webprofusion/open-pedal/enclosure/assets/tablet-screen.png

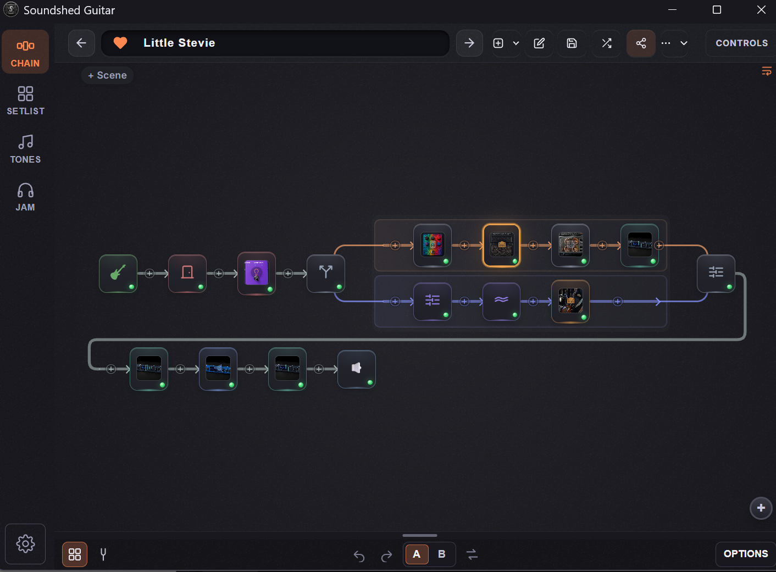
enclosure/assets/tablet-screen.png
