webprofusion/open-pedal/enclosure/renders/holder-phone.png

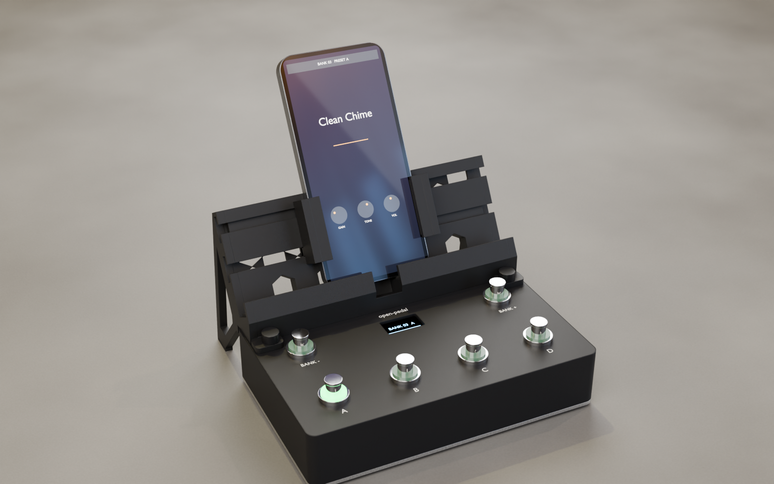
enclosure/renders/holder-phone.png
