webprofusion/open-pedal/enclosure/renders/holder-rear.png

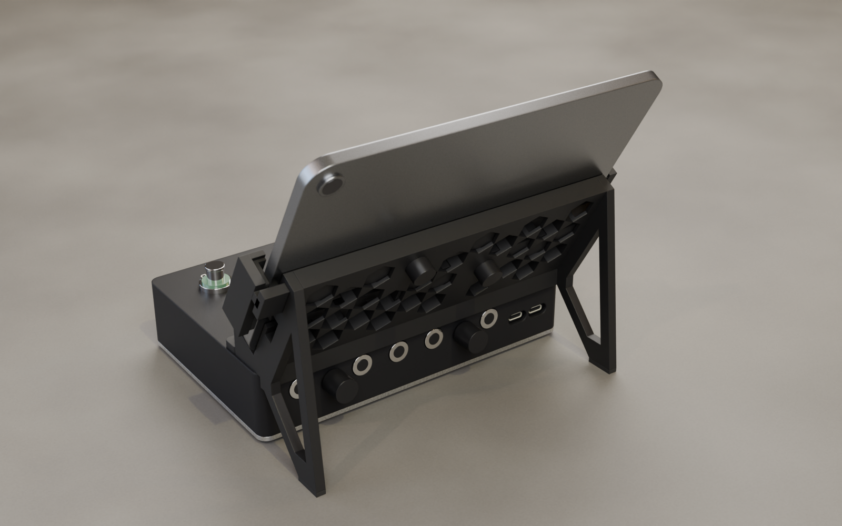
enclosure/renders/holder-rear.png
