webprofusion/open-pedal/enclosure/renders/inside.png

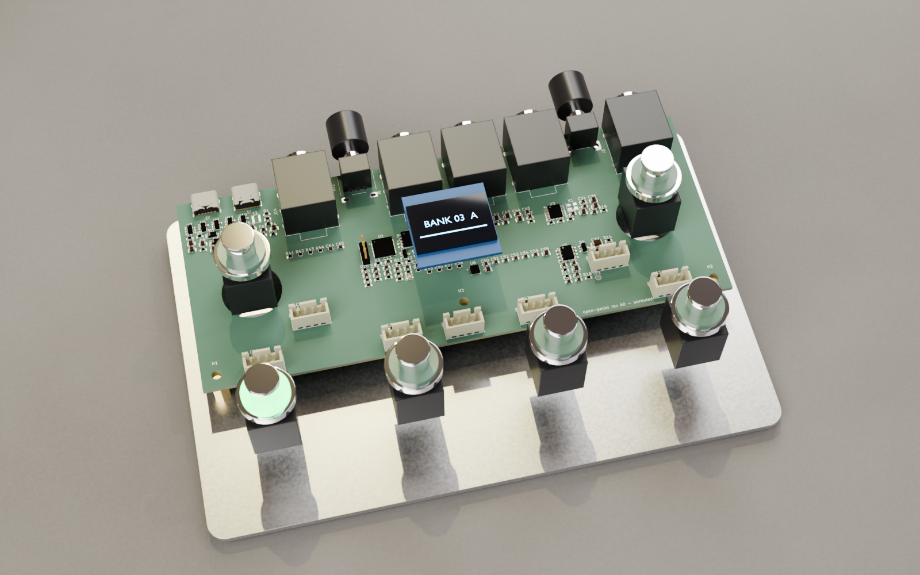
enclosure/renders/inside.png
