webprofusion/open-pedal/enclosure/renders/rear.png

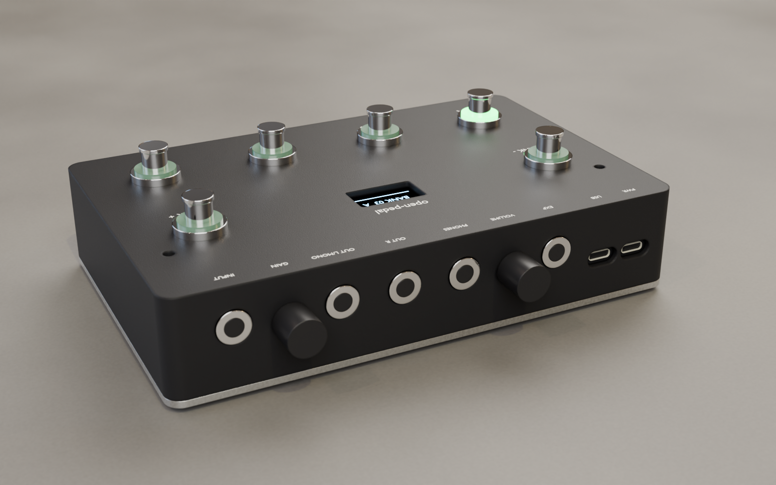
enclosure/renders/rear.png
