webprofusion/open-pedal/hardware/kicad/exports/open-pedal-board.png

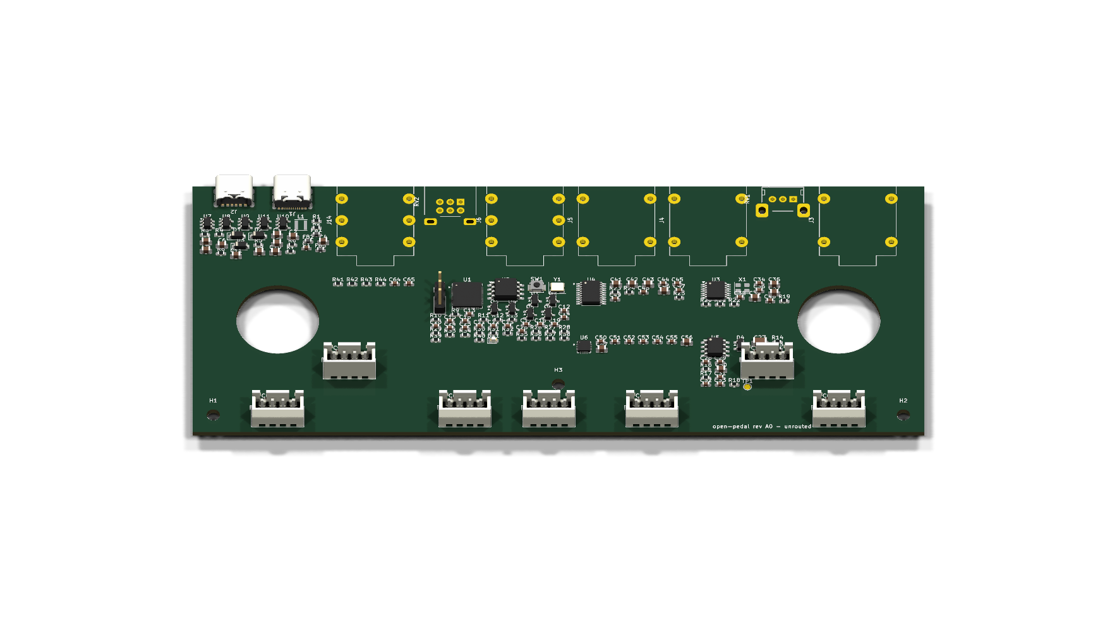
hardware/kicad/exports/open-pedal-board.png
