webprofusion/open-pedal/hardware/kicad/exports/open-pedal-schematic.pdf

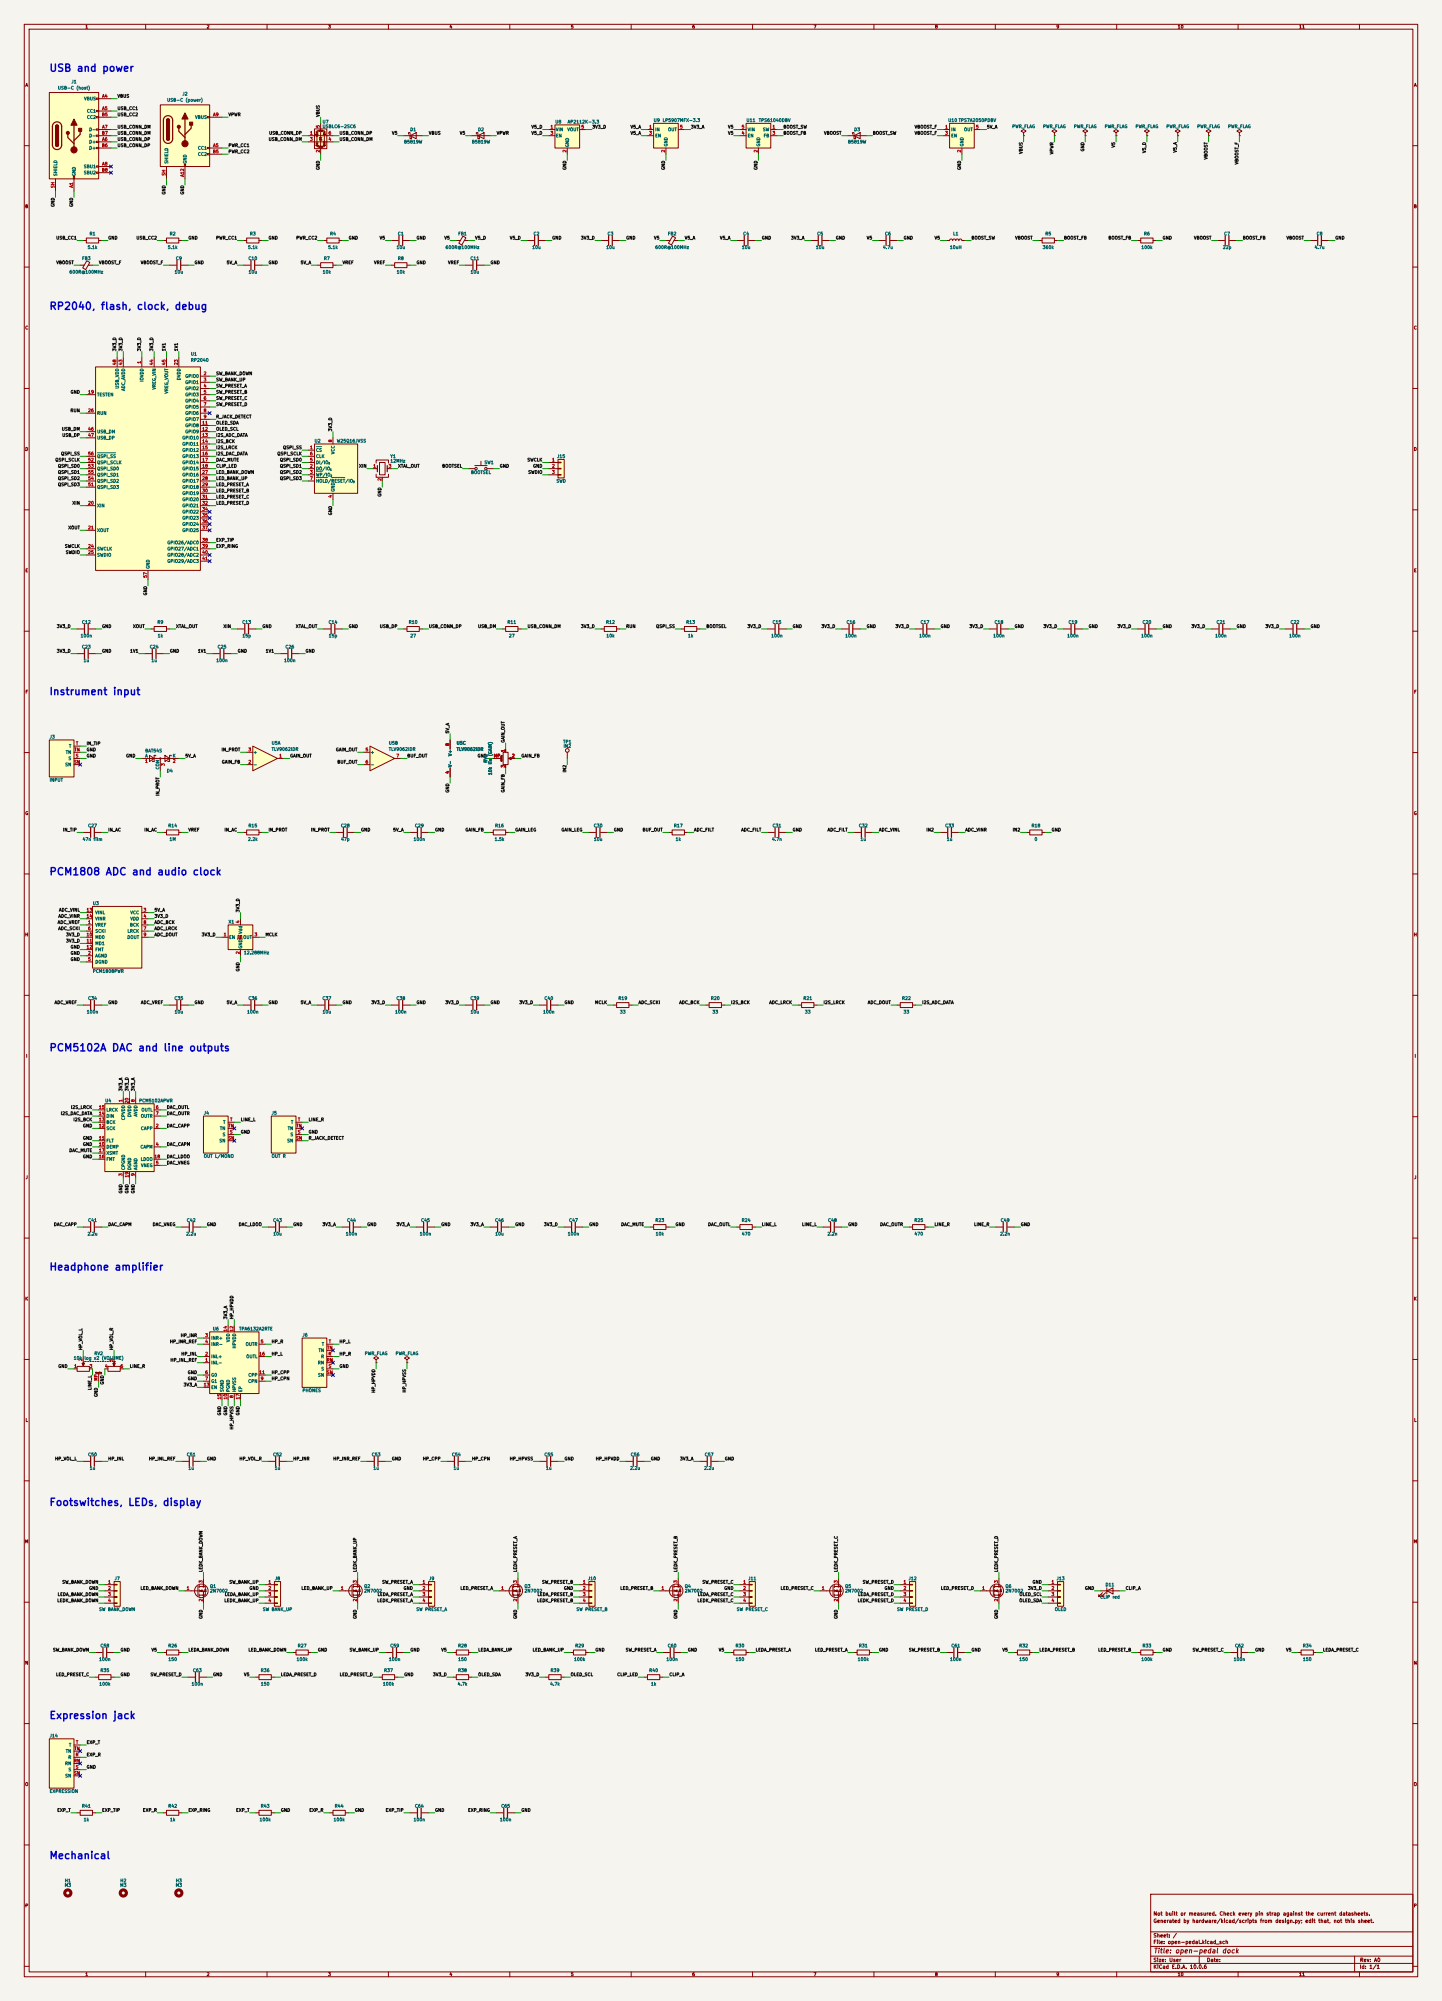
[picture p9: page 1]

4 DI/IO0 5 CLK 6 HOLD/RESET/IO3 7 VCC U2 8W25Q16JVSS

PCM1808 ADC and audio clock

PCM5102A DAC and line outputs

SCK 12 BCK 13 DIN 14 LRCK 15

8 CPN 9 PGND 10 CPP 11 HPVDD 12

GND Footswitches, LEDs, display

Not built or measured. Check every pin strap against the current datasheets.
Generated by hardware/kicad/scripts from design.py; edit that, not this sheet.

Sheet: /
File: open-pedal.kicad_sch
Title: open-pedal dock

Size: User | Rev: A0
KiCad E.D.A. 10.0.6 | Id: 1/1
