webprofusion/open-pedal/hardware/kicad/open-pedal.kicad_pcb

## KiCad design hardware/kicad/open-pedal.kicad_pcb (2026-11-10)

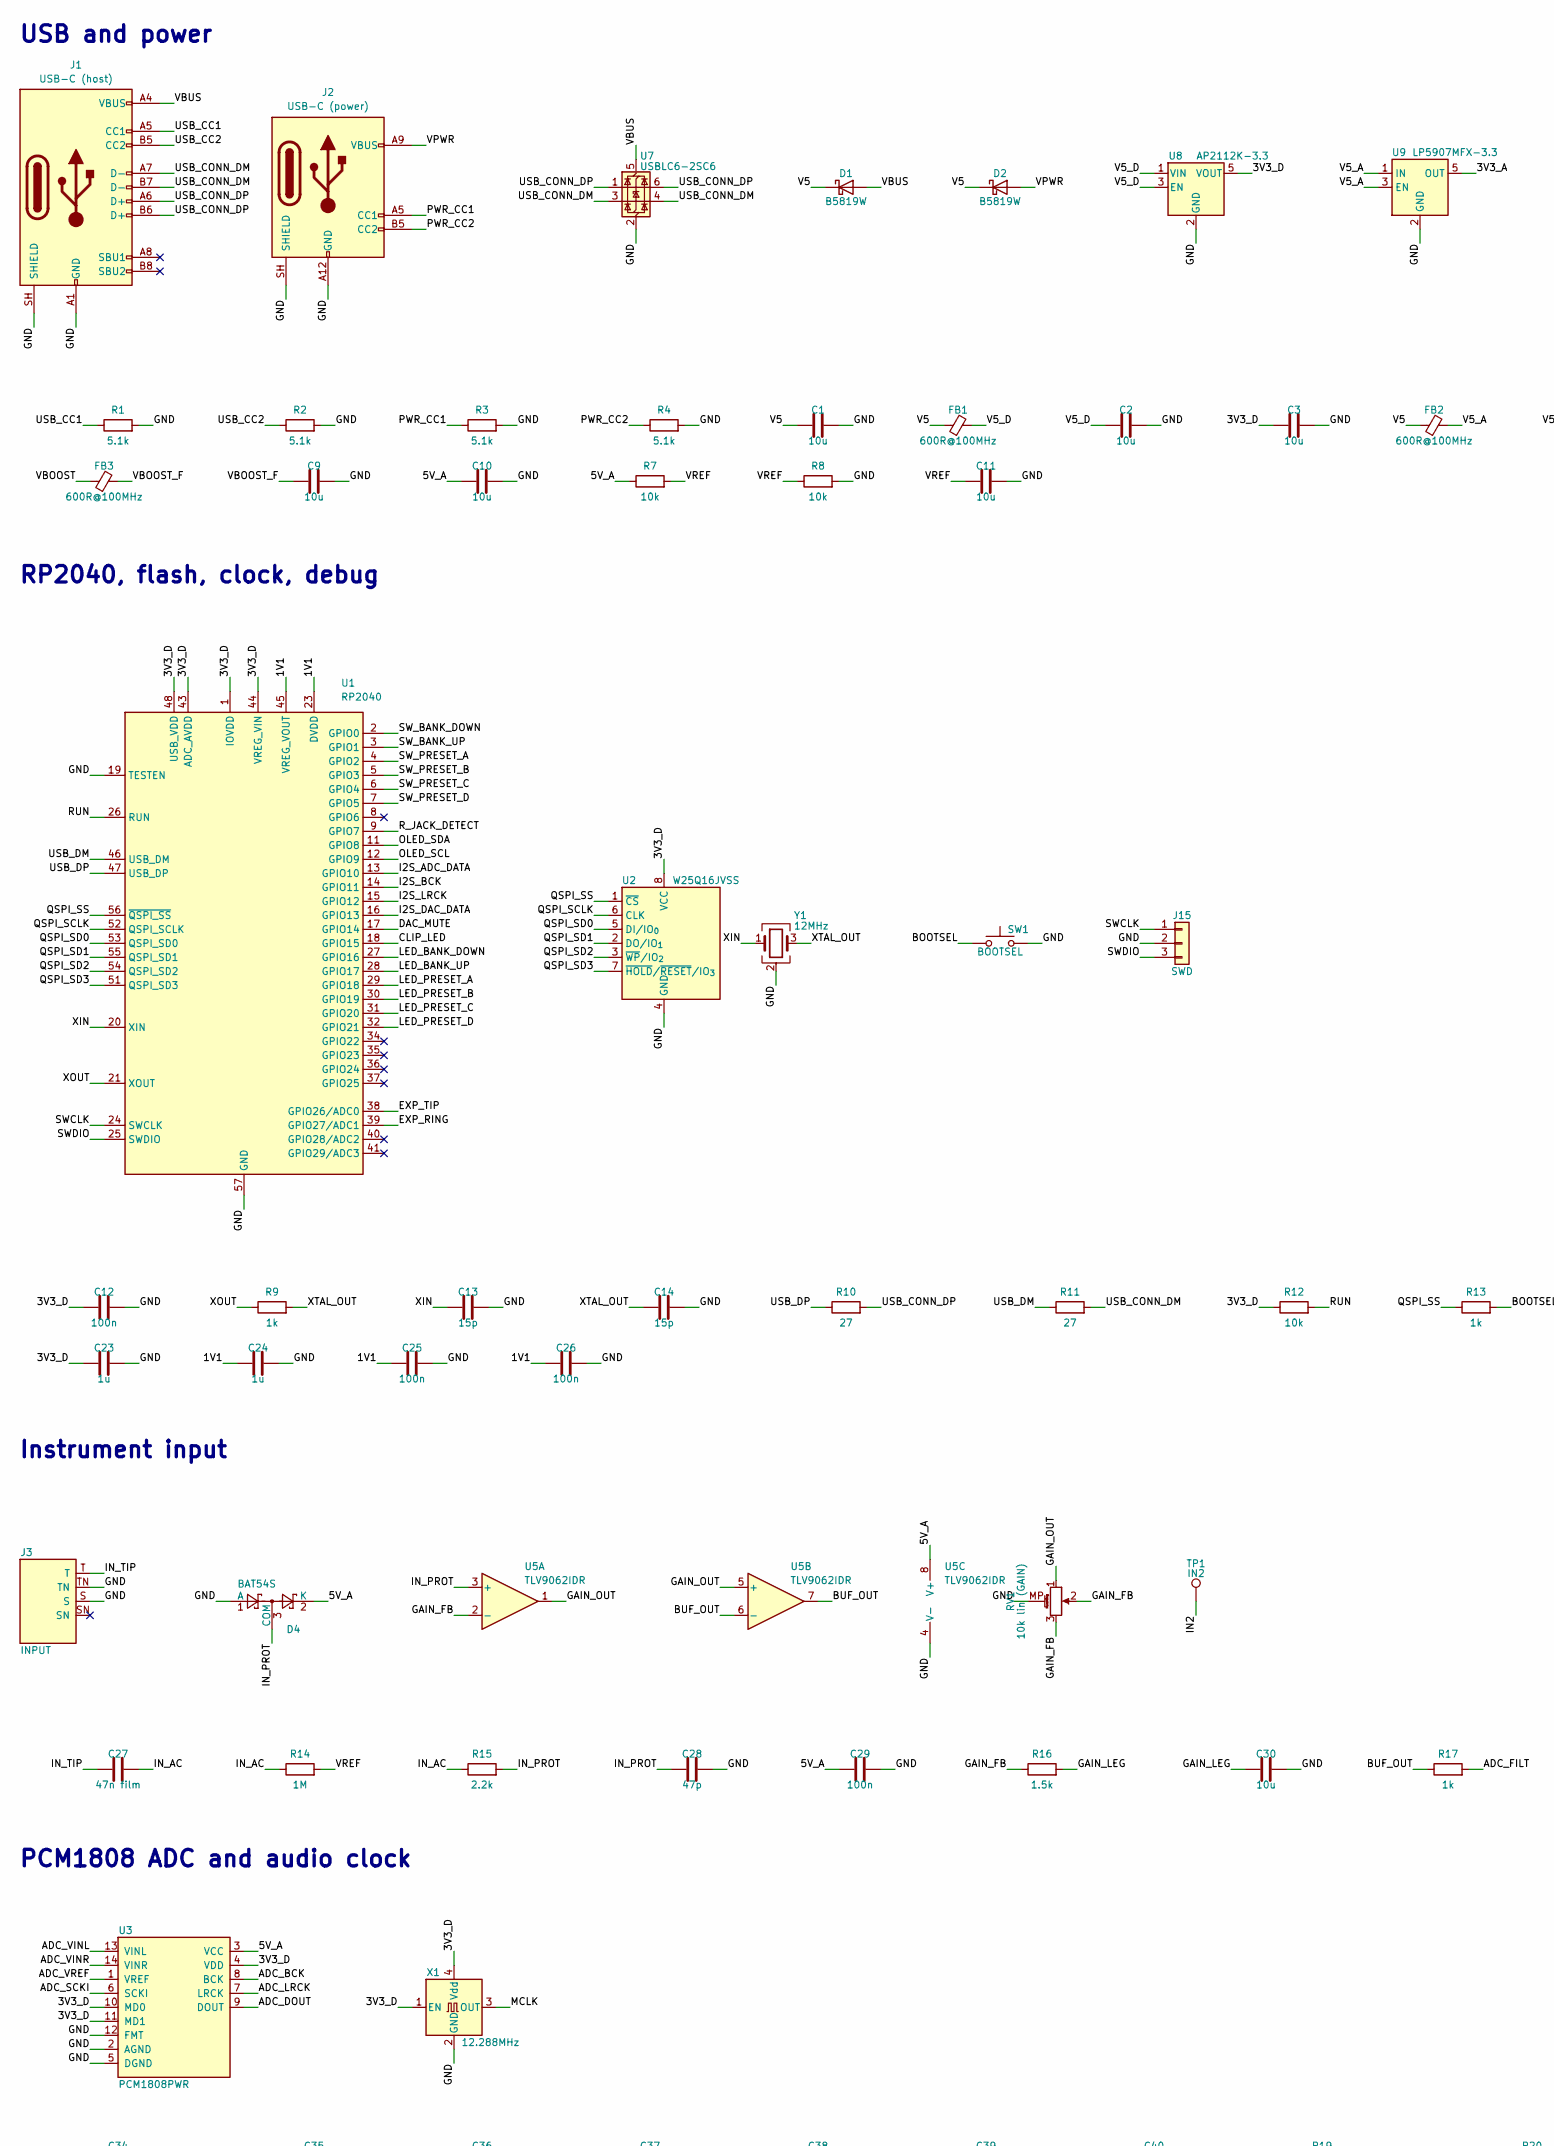
[picture p10: schematic open-pedal.kicad_sch, open-pedal dock, part in row 1, column 1]

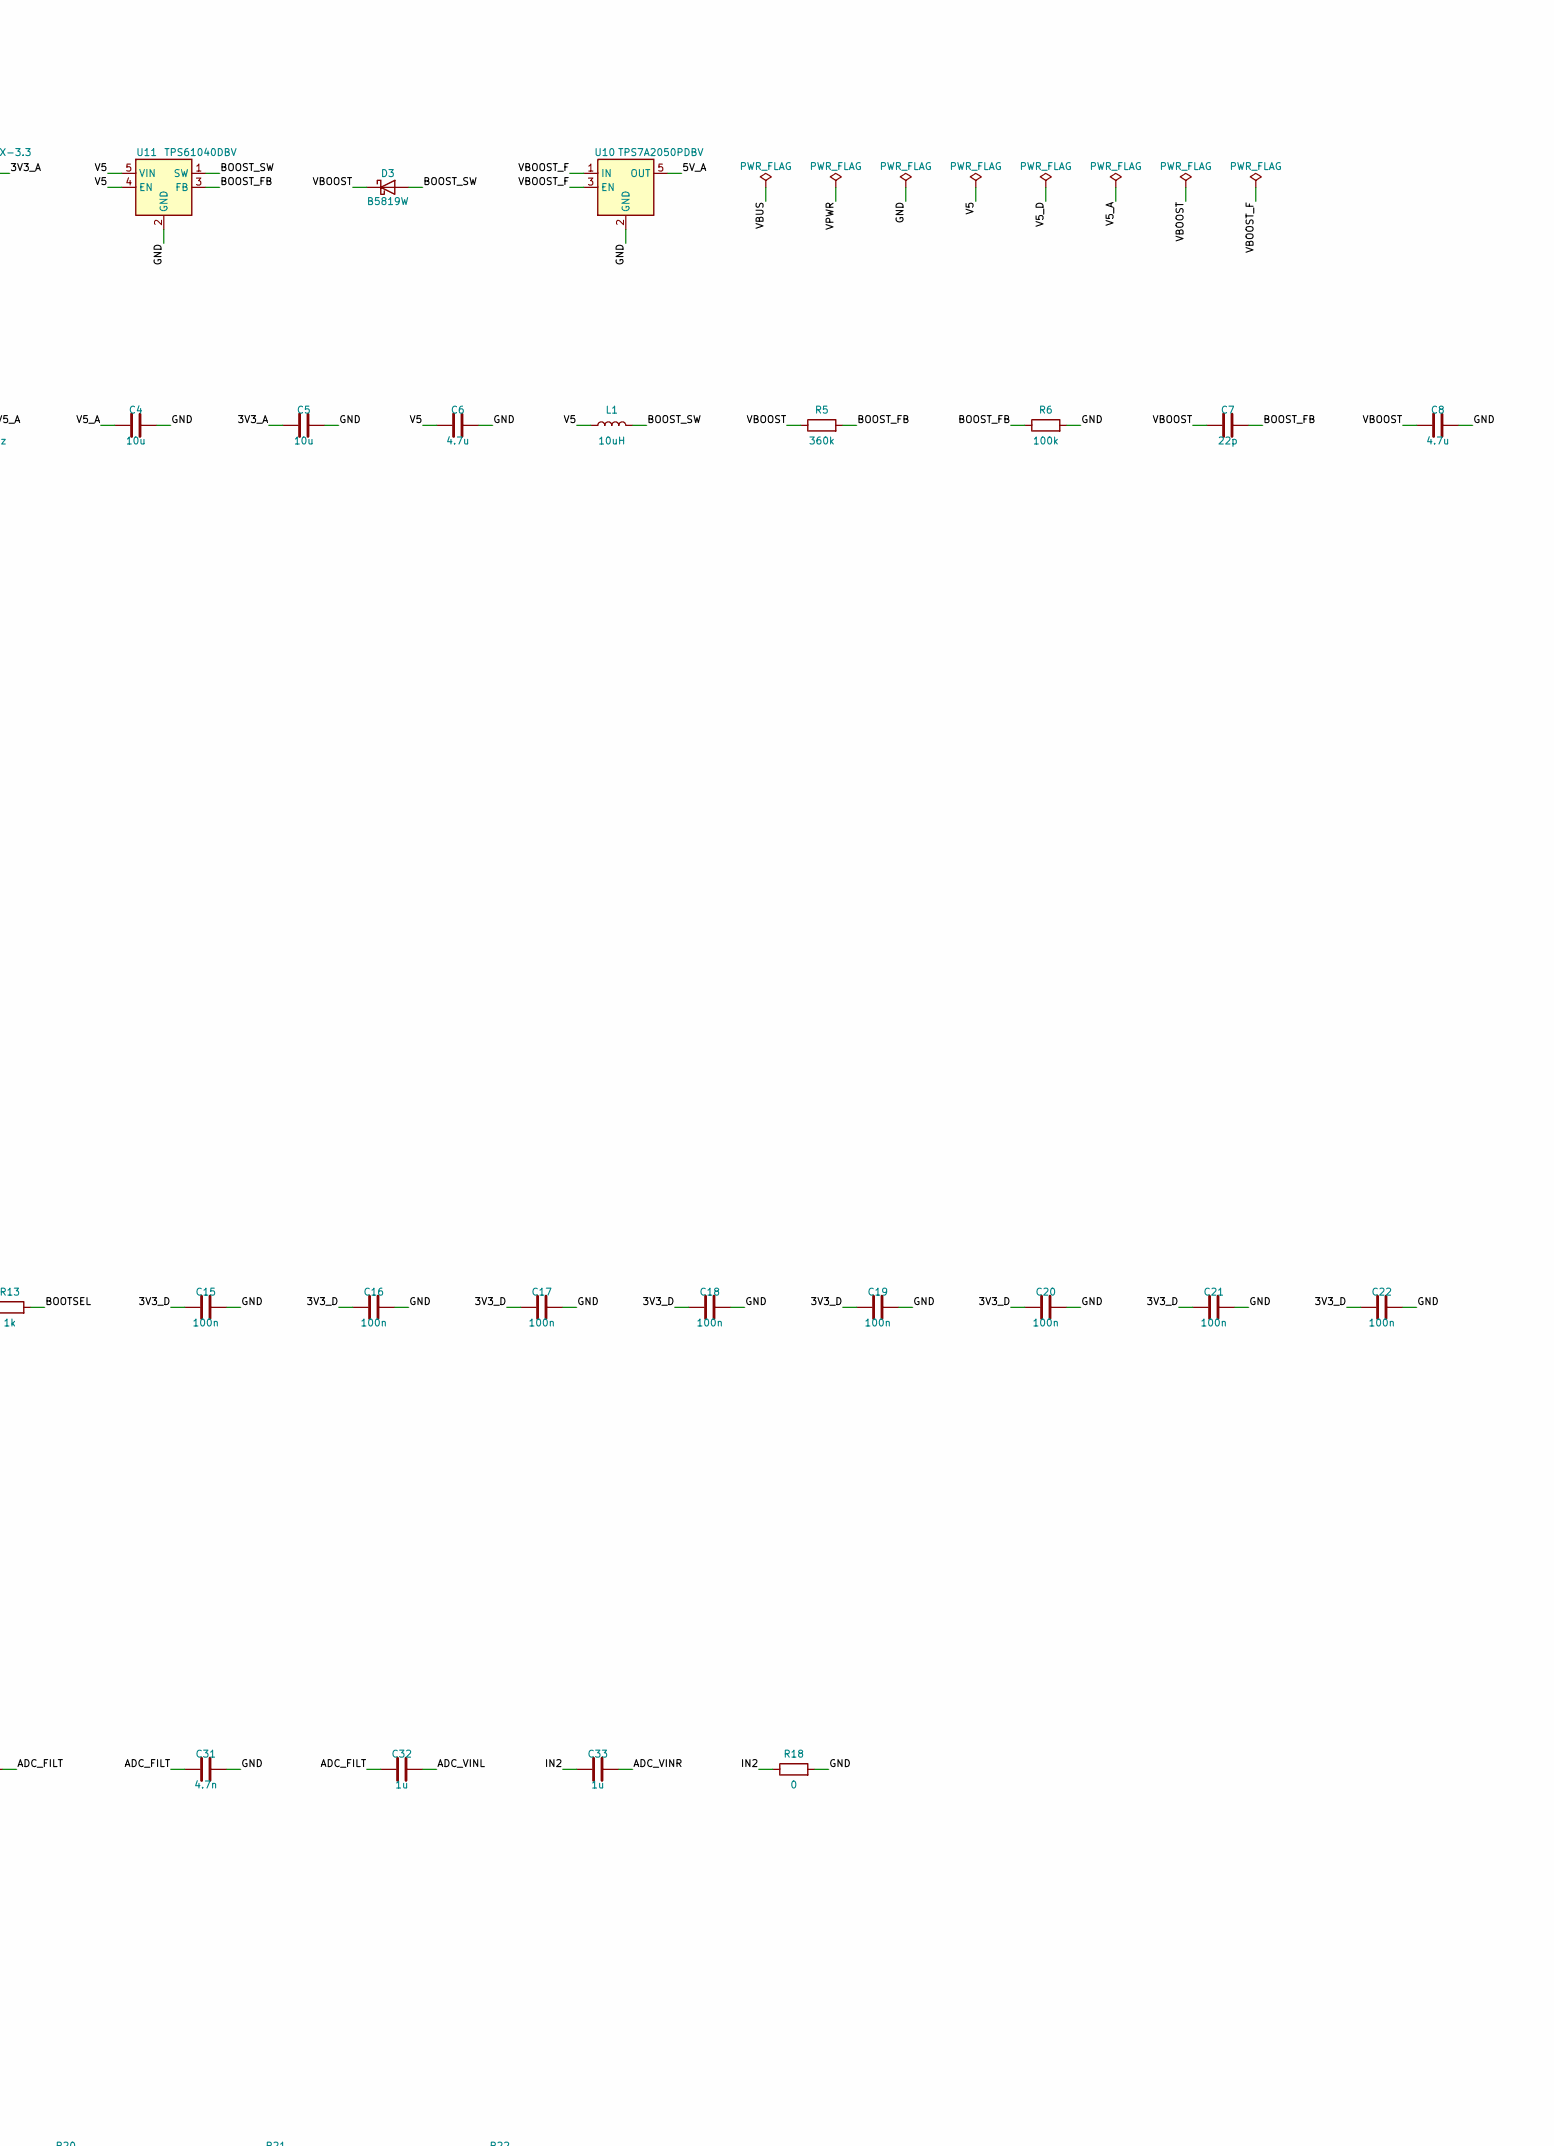
[picture p11: schematic open-pedal.kicad_sch, open-pedal dock, part in row 1, column 2]

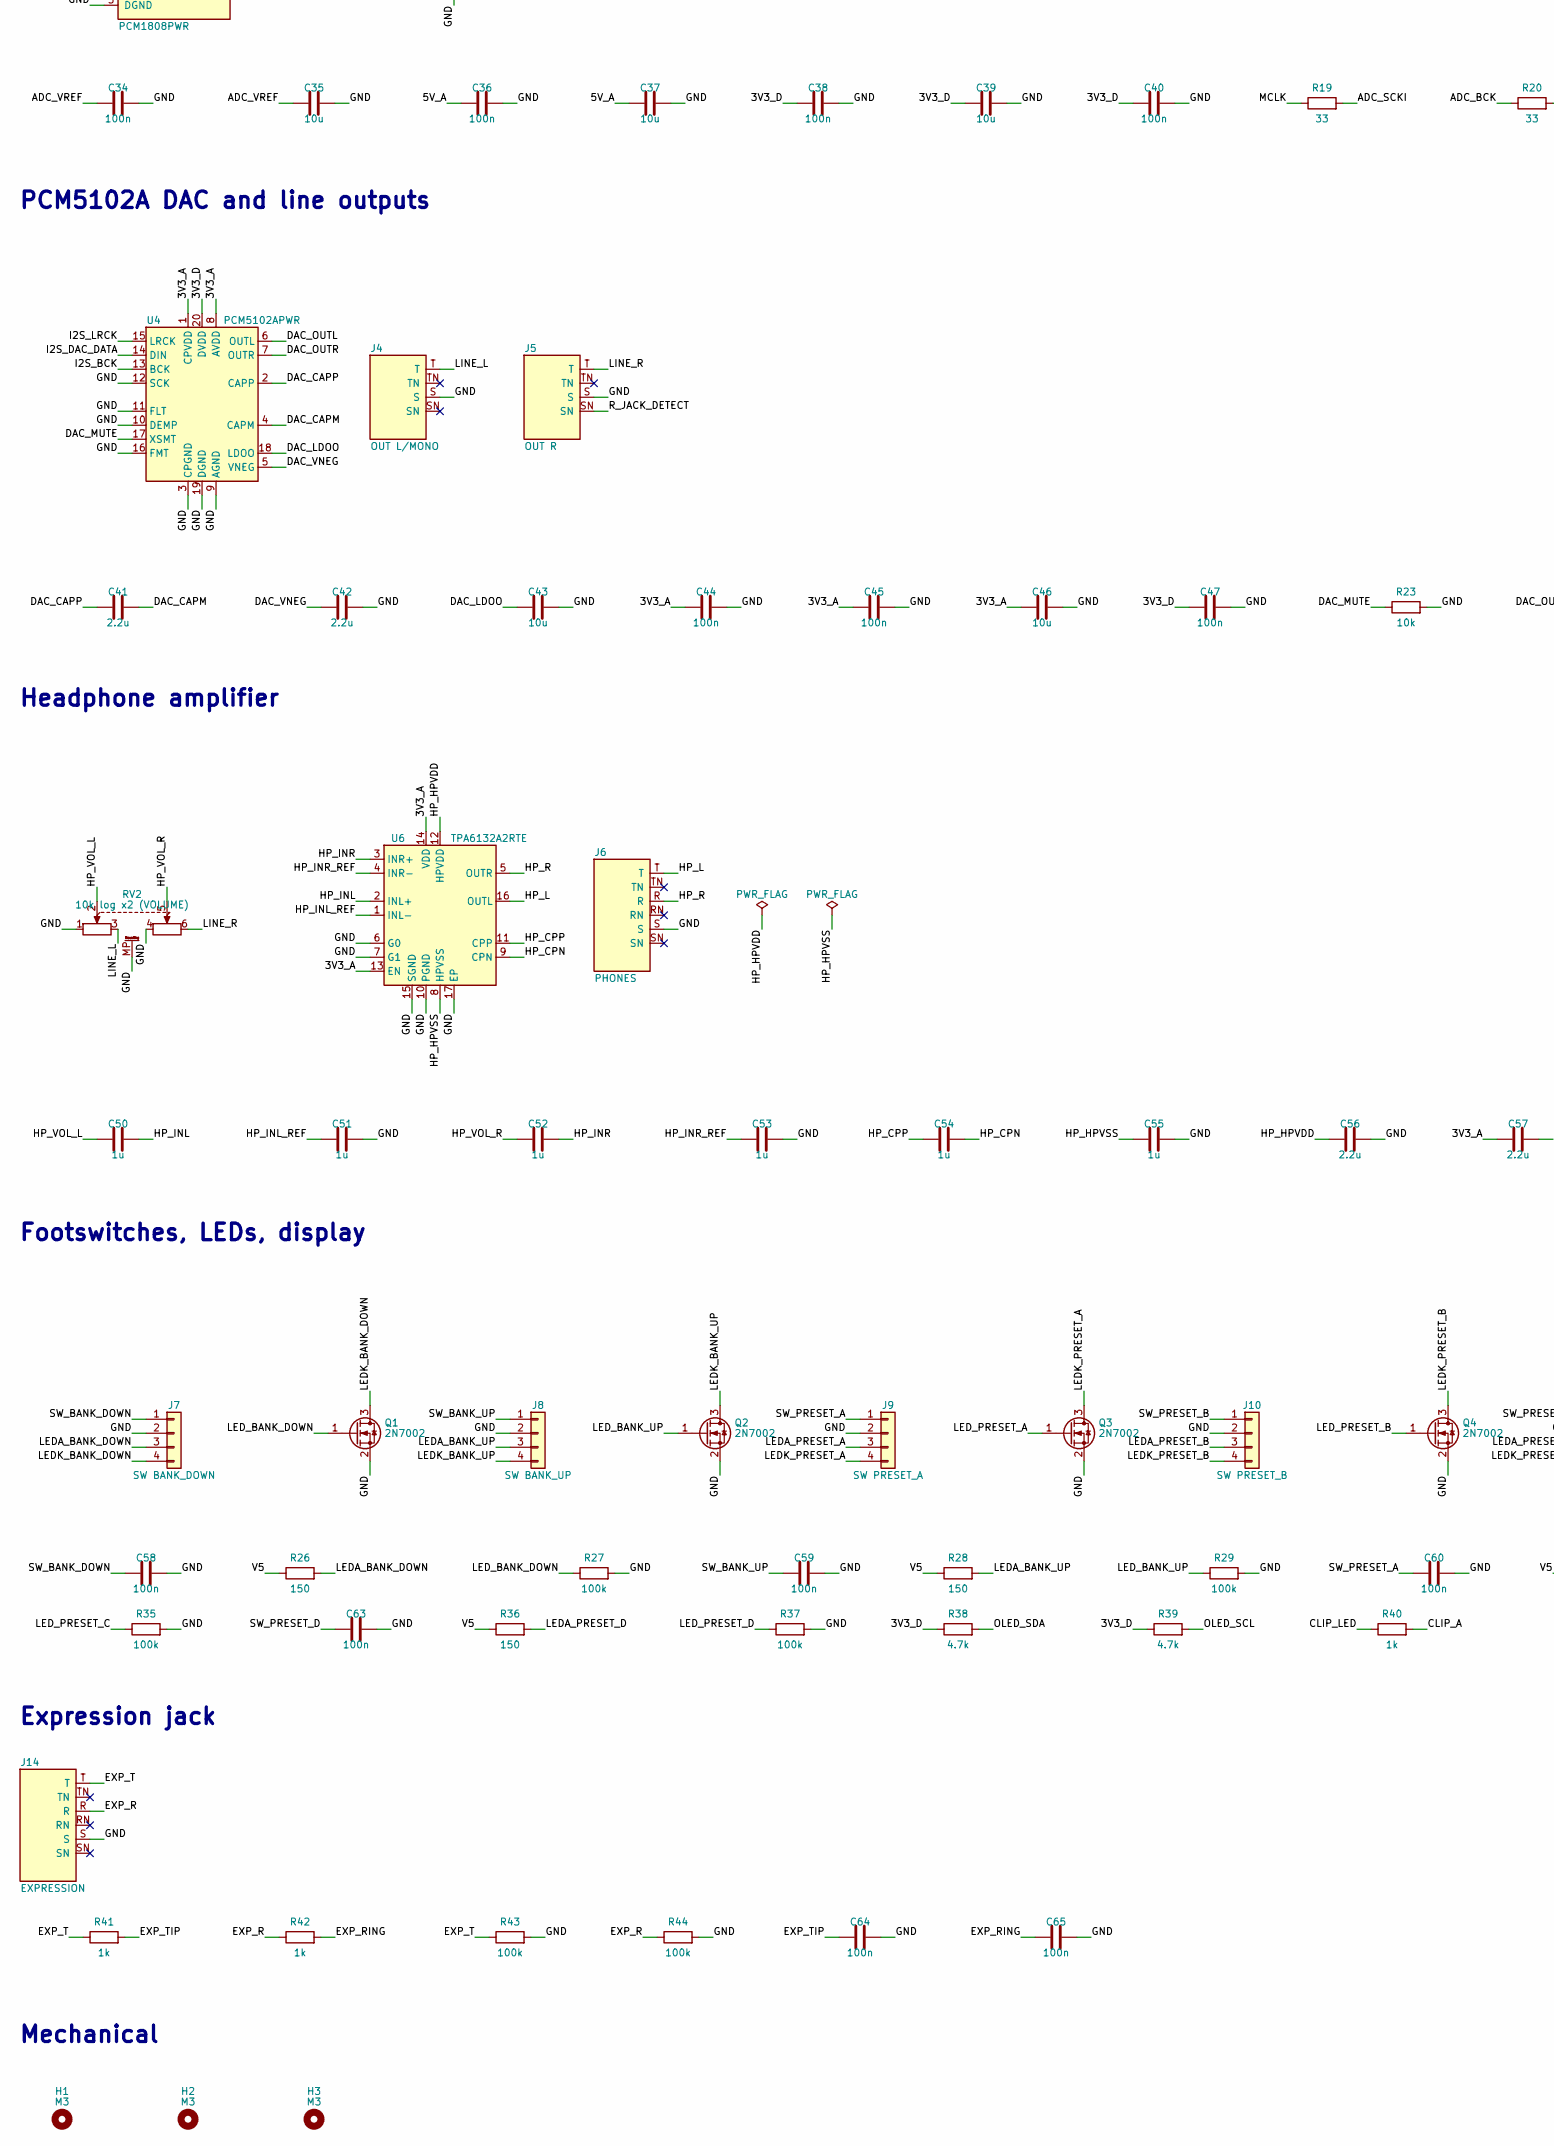
[picture p12: schematic open-pedal.kicad_sch, open-pedal dock, part in row 2, column 1]

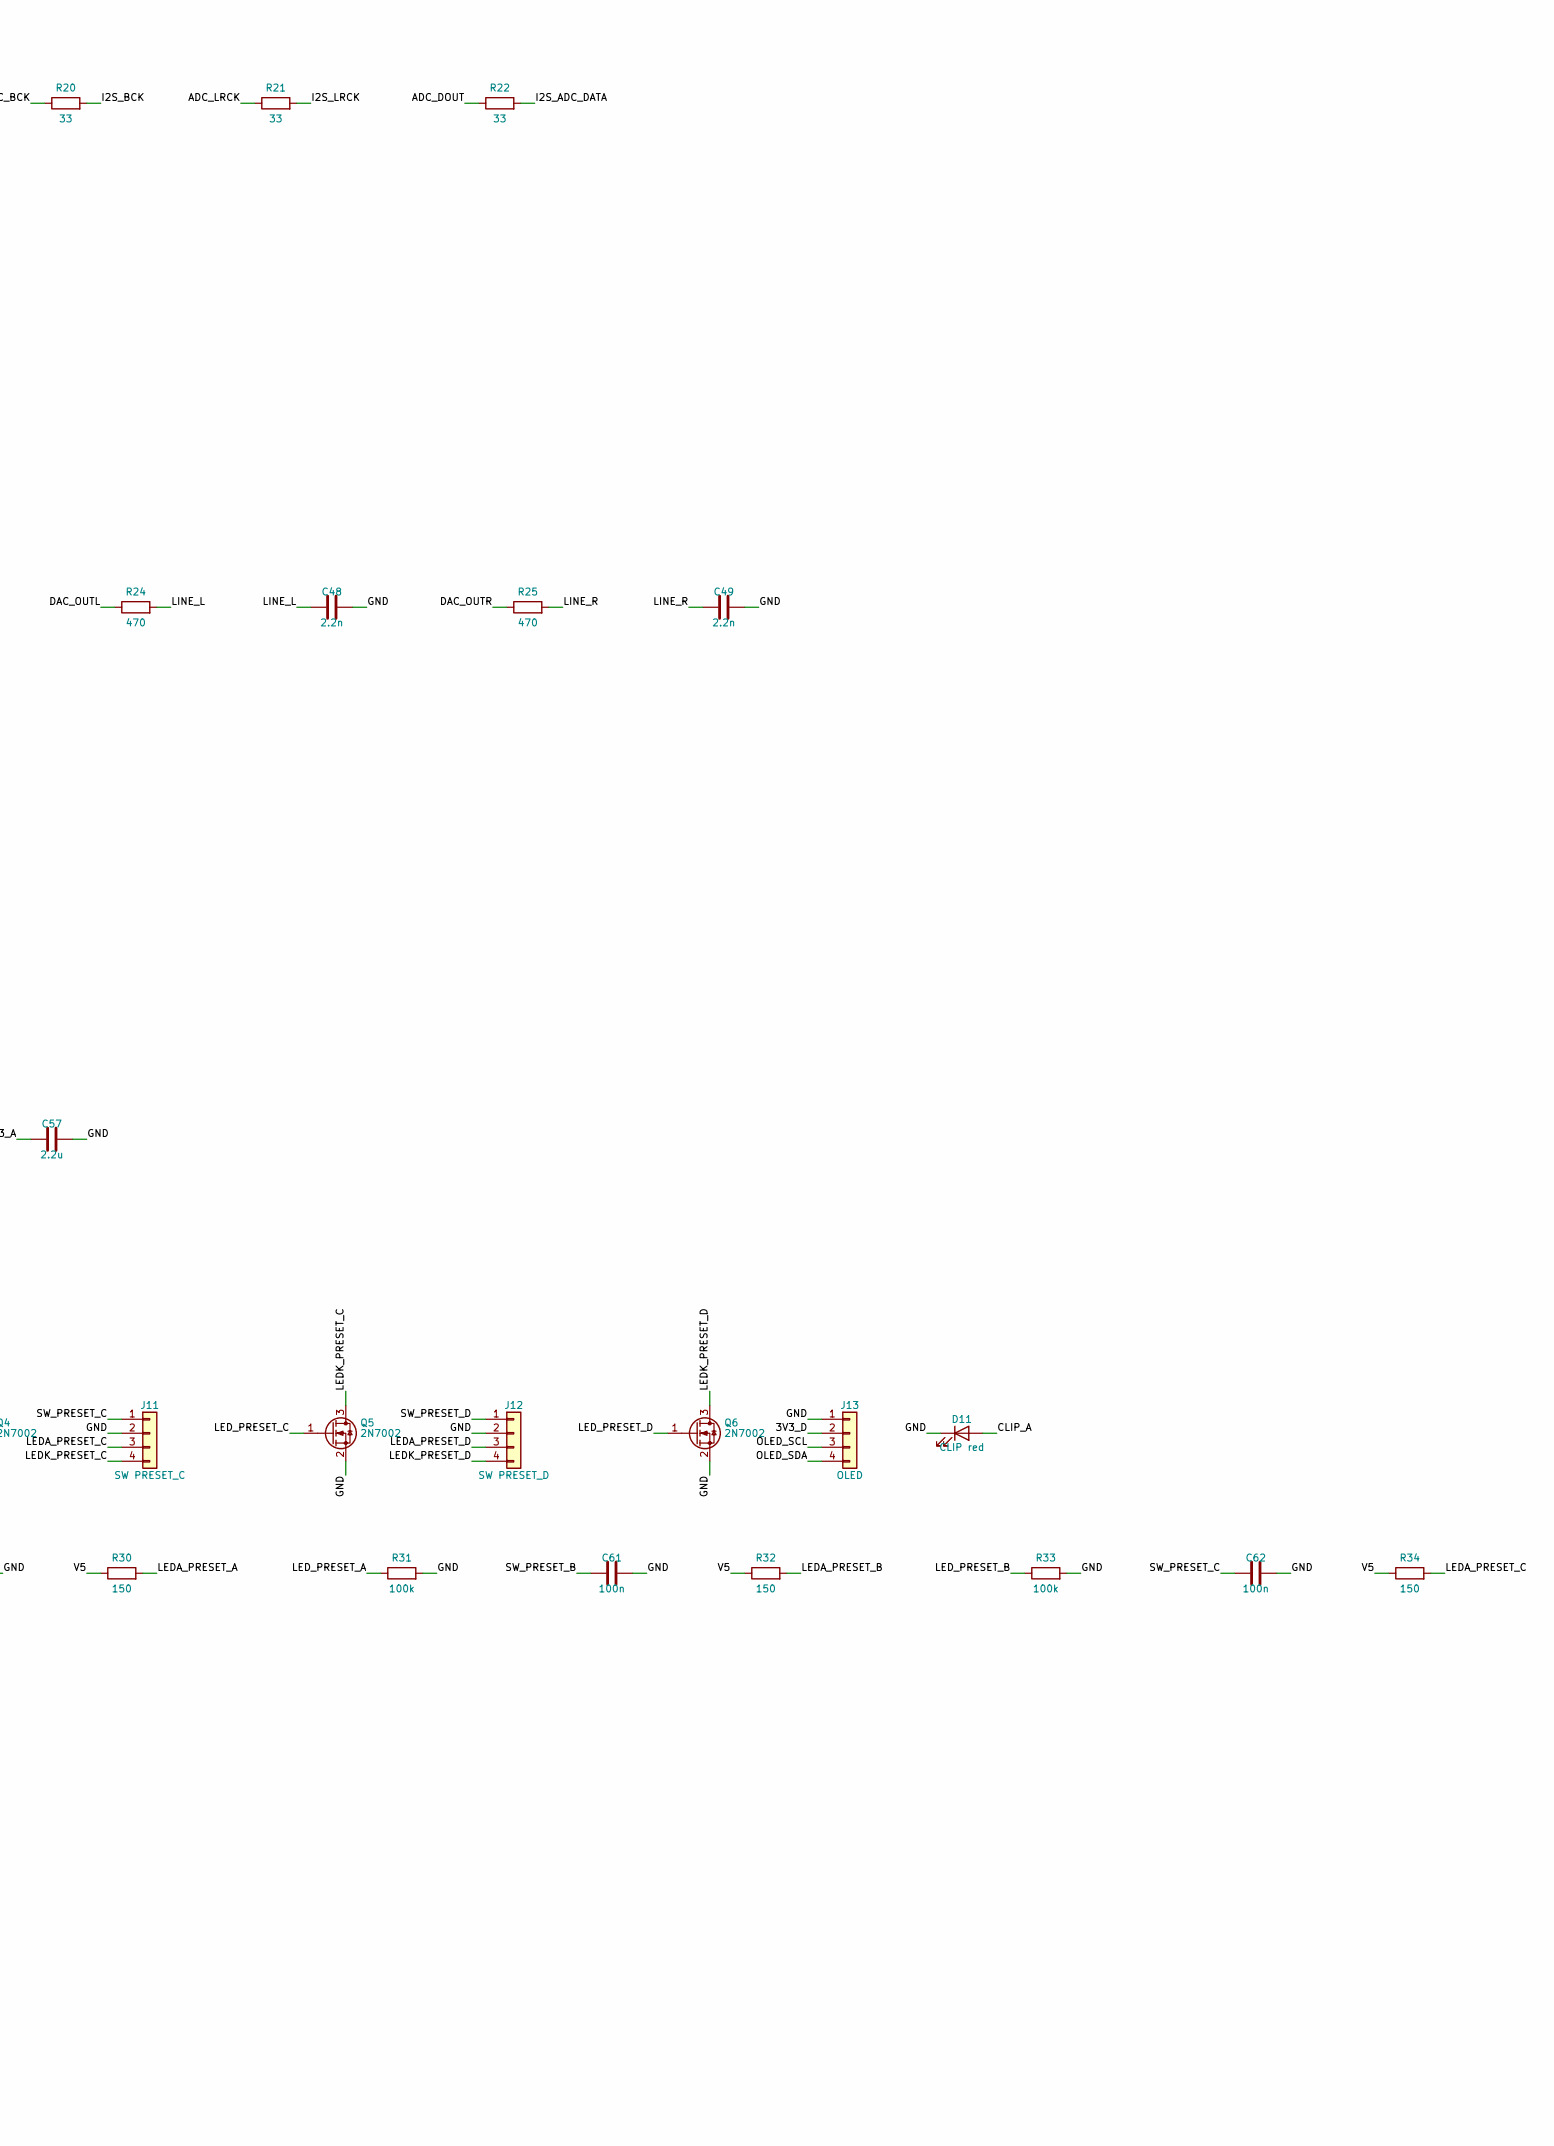
[picture p13: schematic open-pedal.kicad_sch, open-pedal dock, part in row 2, column 2]

Parts:
C1, C2, C3, C4, C5, C9, C10, C11, C30, C35, C37, C39, C43, C46: 10u; C_0805_2012Metric
C6, C8: 4.7u; C_0805_2012Metric
C7: 22p; C_0603_1608Metric
C12, C15, C16, C17, C18, C19, C20, C21, C22, C25, C26, C29, C34, C36, C38, C40, C44, C45, C47, C58, C59, C60, C61, C62, C63, C64, C65: 100n; C_0603_1608Metric
C13, C14: 15p; C_0603_1608Metric
C23, C24, C32, C33, C50, C51, C52, C53, C54, C55: 1u; C_0603_1608Metric
C27: 47n film; C_1206_3216Metric
C28: 47p; C_0603_1608Metric
C31: 4.7n; C_0603_1608Metric
C41, C42, C56, C57: 2.2u; C_0805_2012Metric
C48, C49: 2.2n; C_0603_1608Metric
D1, D2, D3: B5819W; D_SOD-123
D4: BAT54S; SOT-23
D11: CLIP red; LED_0603_1608Metric
FB1, FB2, FB3: 600R@100MHz; L_0603_1608Metric
H1, H2, H3: M3; MountingHole_3.2mm_M3
J1: USB-C (host); USB_C_Receptacle_GCT_USB4105-xx-A_16P_TopMnt_Horizontal
J2: USB-C (power); USB_C_Receptacle_GCT_USB4125-xx-x_6P_TopMnt_Horizontal
J3: INPUT; Jack_6.35mm_Neutrik_NMJ4HCD2_Horizontal
J4: OUT L/MONO; Jack_6.35mm_Neutrik_NMJ4HCD2_Horizontal
J5: OUT R; Jack_6.35mm_Neutrik_NMJ4HCD2_Horizontal
J6: PHONES; Jack_6.35mm_Neutrik_NMJ6HCD2_Horizontal
J7: SW BANK_DOWN; JST_XH_B4B-XH-A_1x04_P2.50mm_Vertical
J8: SW BANK_UP; JST_XH_B4B-XH-A_1x04_P2.50mm_Vertical
J9: SW PRESET_A; JST_XH_B4B-XH-A_1x04_P2.50mm_Vertical
J10: SW PRESET_B; JST_XH_B4B-XH-A_1x04_P2.50mm_Vertical
J11: SW PRESET_C; JST_XH_B4B-XH-A_1x04_P2.50mm_Vertical
J12: SW PRESET_D; JST_XH_B4B-XH-A_1x04_P2.50mm_Vertical
J13: OLED; JST_XH_B4B-XH-A_1x04_P2.50mm_Vertical
J14: EXPRESSION; Jack_6.35mm_Neutrik_NMJ6HCD2_Horizontal
J15: SWD; PinHeader_1x03_P2.54mm_Vertical
L1: 10uH; L_Taiyo-Yuden_NR-30xx
Q1, Q2, Q3, Q4, Q5, Q6: 2N7002; SOT-23
R1, R2, R3, R4: 5.1k; R_0603_1608Metric
R5: 360k; R_0603_1608Metric
R6, R27, R29, R31, R33, R35, R37, R43, R44: 100k; R_0603_1608Metric
R7, R8, R12, R23: 10k; R_0603_1608Metric
R9, R13, R17, R40, R41, R42: 1k; R_0603_1608Metric
R10, R11: 27; R_0603_1608Metric
R14: 1M; R_0603_1608Metric
R15: 2.2k; R_0603_1608Metric
R16: 1.5k; R_0603_1608Metric
R18: 0; R_0603_1608Metric
R19, R20, R21, R22: 33; R_0603_1608Metric
R24, R25: 470; R_0603_1608Metric
R26, R28, R30, R32, R34, R36: 150; R_0603_1608Metric
R38, R39: 4.7k; R_0603_1608Metric
RV1: 10k lin (GAIN); Potentiometer_Alps_RK09K_Single_Horizontal
RV2: 10k log x2 (VOLUME); Potentiometer_Alps_RK09L_Double_Horizontal
SW1: BOOTSEL; SW_SPST_B3U-1000P
TP1: IN2; TestPoint_Pad_D1.5mm
U1: RP2040; QFN-56-1EP_7x7mm_P0.4mm_EP3.2x3.2mm
U2: W25Q16JVSS; SOIC-8_5.3x5.3mm_P1.27mm
U3: PCM1808PWR; TSSOP-14_4.4x5mm_P0.65mm
U4: PCM5102APWR; TSSOP-20_4.4x6.5mm_P0.65mm
U5: TLV9062IDR; SOIC-8_3.9x4.9mm_P1.27mm
U6: TPA6132A2RTE; WQFN-16-1EP_3x3mm_P0.5mm_EP1.6x1.6mm
U7: USBLC6-2SC6; SOT-23-6
U8: AP2112K-3.3; SOT-23-5
U9: LP5907MFX-3.3; SOT-23-5
U10: TPS7A2050PDBV; SOT-23-5
U11: TPS61040DBV; SOT-23-5
X1: 12.288MHz; Oscillator_SMD_Abracon_ASE-4Pin_3.2x2.5mm
Y1: 12MHz; Crystal_SMD_3225-4Pin_3.2x2.5mm

Connections:
1V1: C24.1, C25.1, C26.1, U1.23 (DVDD), U1.45 (VREG_VOUT), U1.50 (DVDD)
3V3_A: C5.1, C44.1, C45.1, C46.1, C57.1, U4.1 (CPVDD), U4.8 (AVDD), U6.13 (EN), U6.14 (VDD), U9.5 (OUT)
3V3_D: C3.1, C12.1, C15.1, C16.1, C17.1, C18.1, C19.1, C20.1, C21.1, C22.1, C23.1, C38.1, C39.1, C40.1, C47.1, J13.2, R12.1, R38.1, R39.1, U1.1 (IOVDD), U1.10 (IOVDD), U1.22 (IOVDD), U1.33 (IOVDD), U1.42 (IOVDD), U1.43 (ADC_AVDD), U1.44 (VREG_VIN), U1.48 (USB_VDD), U1.49 (IOVDD), U2.8 (VCC), U3.4 (VDD), U3.10 (MD0), U3.11 (MD1), U4.20 (DVDD), U8.5 (VOUT), X1.1 (EN), X1.4 (Vdd)
5V_A: C10.1, C29.1, C36.1, C37.1, D4.2 (K), R7.1, U3.3 (VCC), U5.8 (V+), U10.5 (OUT)
ADC_BCK: R20.1, U3.8 (BCK)
ADC_DOUT: R22.1, U3.9 (DOUT)
ADC_FILT: C31.1, C32.1, R17.2
ADC_LRCK: R21.1, U3.7 (LRCK)
ADC_SCKI: R19.2, U3.6 (SCKI)
ADC_VINL: C32.2, U3.13 (VINL)
ADC_VINR: C33.2, U3.14 (VINR)
ADC_VREF: C34.1, C35.1, U3.1 (VREF)
BOOST_FB: C7.2, R5.2, R6.1, U11.3 (FB)
BOOST_SW: D3.2 (A), L1.2, U11.1 (SW)
BOOTSEL: R13.2, SW1.1
BUF_OUT: R17.1, U5.6 (-), U5.7
CLIP_A: D11.2 (A), R40.2
CLIP_LED: R40.1, U1.18 (GPIO15)
DAC_CAPM: C41.2, U4.4 (CAPM)
DAC_CAPP: C41.1, U4.2 (CAPP)
DAC_LDOO: C43.1, U4.18 (LDOO)
DAC_MUTE: R23.1, U1.17 (GPIO14), U4.17 (XSMT)
DAC_OUTL: R24.1, U4.6 (OUTL)
DAC_OUTR: R25.1, U4.7 (OUTR)
DAC_VNEG: C42.1, U4.5 (VNEG)
EXP_R: J14.R, R42.1, R44.1
EXP_RING: C65.1, R42.2, U1.39 (GPIO27/ADC1)
EXP_T: J14.T, R41.1, R43.1
EXP_TIP: C64.1, R41.2, U1.38 (GPIO26/ADC0)
GAIN_FB: R16.1, RV1.2, RV1.3, U5.2 (-)
GAIN_LEG: C30.1, R16.2
GAIN_OUT: RV1.1, U5.1, U5.5 (+)
GND: C1.2, C2.2, C3.2, C4.2, C5.2, C6.2, C8.2, C9.2, C10.2, C11.2, C12.2, C13.2, C14.2, C15.2, C16.2, C17.2, C18.2, C19.2, C20.2, C21.2, C22.2, C23.2, C24.2, C25.2, C26.2, C28.2, C29.2, C30.2, C31.2, C34.2, C35.2, C36.2, C37.2, C38.2, C39.2, C40.2, C42.2, C43.2, C44.2, C45.2, C46.2, C47.2, C48.2, C49.2, C51.2, C53.2, C55.2, C56.2, C57.2, C58.2, C59.2, C60.2, C61.2, C62.2, C63.2, C64.2, C65.2, D4.1 (A), D11.1 (K), J1.A1 (GND), J1.A12 (GND), J1.B1 (GND), J1.B12 (GND), J1.SH (SHIELD), J2.A12 (GND), J2.B12 (GND), J2.SH (SHIELD), J3.S, J3.TN, J4.S, J5.S, J6.S, J7.2, J8.2, J9.2, J10.2, J11.2, J12.2, J13.1, J14.S, J15.2, Q1.2 (S), Q2.2 (S), Q3.2 (S), Q4.2 (S), Q5.2 (S), Q6.2 (S), R1.2, R2.2, R3.2, R4.2, R6.2, R8.2, R18.2, R23.2, R27.2, R29.2, R31.2, R33.2, R35.2, R37.2, R43.2, R44.2, RV1.MP (MountPin), RV2.1, RV2.4, RV2.MP (MountPin), SW1.2, U1.19 (TESTEN), U1.57 (GND), U2.4 (GND), U3.2 (AGND), U3.5 (DGND), U3.12 (FMT), U4.3 (CPGND), U4.9 (AGND), U4.10 (DEMP), U4.11 (FLT), U4.12 (SCK), U4.16 (FMT), U4.19 (DGND), U5.4 (V-), U6.6 (G0), U6.7 (G1), U6.10 (PGND), U6.15 (SGND), U6.17 (EP), U7.2 (GND), U8.2 (GND), U9.2 (GND), U10.2 (GND), U11.2 (GND), X1.2 (GND), Y1.2 (G), Y1.4 (G)
HP_CPN: C54.2, U6.9 (CPN)
HP_CPP: C54.1, U6.11 (CPP)
HP_HPVDD: C56.1, U6.12 (HPVDD)
HP_HPVSS: C55.1, U6.8 (HPVSS)
HP_INL: C50.2, U6.2 (INL+)
HP_INL_REF: C51.1, U6.1 (INL-)
HP_INR: C52.2, U6.3 (INR+)
HP_INR_REF: C53.1, U6.4 (INR-)
HP_L: J6.T, U6.16 (OUTL)
HP_R: J6.R, U6.5 (OUTR)
HP_VOL_L: C50.1, RV2.2
HP_VOL_R: C52.1, RV2.5
I2S_ADC_DATA: R22.2, U1.13 (GPIO10)
I2S_BCK: R20.2, U1.14 (GPIO11), U4.13 (BCK)
I2S_DAC_DATA: U1.16 (GPIO13), U4.14 (DIN)
I2S_LRCK: R21.2, U1.15 (GPIO12), U4.15 (LRCK)
IN2: C33.1, R18.1, TP1.1
IN_AC: C27.2, R14.1, R15.1
IN_PROT: C28.1, D4.3 (COM), R15.2, U5.3 (+)
IN_TIP: C27.1, J3.T
LEDA_BANK_DOWN: J7.3, R26.2
LEDA_BANK_UP: J8.3, R28.2
LEDA_PRESET_A: J9.3, R30.2
LEDA_PRESET_B: J10.3, R32.2
LEDA_PRESET_C: J11.3, R34.2
LEDA_PRESET_D: J12.3, R36.2
LEDK_BANK_DOWN: J7.4, Q1.3 (D)
LEDK_BANK_UP: J8.4, Q2.3 (D)
LEDK_PRESET_A: J9.4, Q3.3 (D)
LEDK_PRESET_B: J10.4, Q4.3 (D)
LEDK_PRESET_C: J11.4, Q5.3 (D)
LEDK_PRESET_D: J12.4, Q6.3 (D)
LED_BANK_DOWN: Q1.1 (G), R27.1, U1.27 (GPIO16)
LED_BANK_UP: Q2.1 (G), R29.1, U1.28 (GPIO17)
LED_PRESET_A: Q3.1 (G), R31.1, U1.29 (GPIO18)
LED_PRESET_B: Q4.1 (G), R33.1, U1.30 (GPIO19)
LED_PRESET_C: Q5.1 (G), R35.1, U1.31 (GPIO20)
LED_PRESET_D: Q6.1 (G), R37.1, U1.32 (GPIO21)
LINE_L: C48.1, J4.T, R24.2, RV2.3
LINE_R: C49.1, J5.T, R25.2, RV2.6
MCLK: R19.1, X1.3 (OUT)
OLED_SCL: J13.3, R39.2, U1.12 (GPIO9)
OLED_SDA: J13.4, R38.2, U1.11 (GPIO8)
PWR_CC1: J2.A5 (CC1), R3.1
PWR_CC2: J2.B5 (CC2), R4.1
QSPI_SCLK: U1.52 (QSPI_SCLK), U2.6 (CLK)
QSPI_SD0: U1.53 (QSPI_SD0), U2.5 (DI/IO_{0})
QSPI_SD1: U1.55 (QSPI_SD1), U2.2 (DO/IO_{1})
QSPI_SD2: U1.54 (QSPI_SD2), U2.3 (~WP/IO_{2})
QSPI_SD3: U1.51 (QSPI_SD3), U2.7 (~HOLD/~RESET/IO_{3})
QSPI_SS: R13.1, U1.56 (~QSPI_SS), U2.1 (~CS)
RUN: R12.2, U1.26 (RUN)
R_JACK_DETECT: J5.SN, U1.9 (GPIO7)
SWCLK: J15.1, U1.24 (SWCLK)
SWDIO: J15.3, U1.25 (SWDIO)
SW_BANK_DOWN: C58.1, J7.1, U1.2 (GPIO0)
SW_BANK_UP: C59.1, J8.1, U1.3 (GPIO1)
SW_PRESET_A: C60.1, J9.1, U1.4 (GPIO2)
SW_PRESET_B: C61.1, J10.1, U1.5 (GPIO3)
SW_PRESET_C: C62.1, J11.1, U1.6 (GPIO4)
SW_PRESET_D: C63.1, J12.1, U1.7 (GPIO5)
USB_CC1: J1.A5 (CC1), R1.1
USB_CC2: J1.B5 (CC2), R2.1
USB_CONN_DM: J1.A7 (D-), J1.B7 (D-), R11.2, U7.3 (I/O2), U7.4 (I/O2)
USB_CONN_DP: J1.A6 (D+), J1.B6 (D+), R10.2, U7.1 (I/O1), U7.6 (I/O1)
USB_DM: R11.1, U1.46 (USB_DM)
USB_DP: R10.1, U1.47 (USB_DP)
V5: C1.1, C6.1, D1.1 (K), D2.1 (K), FB1.1, FB2.1, L1.1, R26.1, R28.1, R30.1, R32.1, R34.1, R36.1, U11.4 (EN), U11.5 (VIN)
V5_A: C4.1, FB2.2, U9.1 (IN), U9.3 (EN)
V5_D: C2.1, FB1.2, U8.1 (VIN), U8.3 (EN)
VBOOST: C7.1, C8.1, D3.1 (K), FB3.1, R5.1
VBOOST_F: C9.1, FB3.2, U10.1 (IN), U10.3 (EN)
VBUS: D1.2 (A), J1.A4 (VBUS), J1.A9 (VBUS), J1.B4 (VBUS), J1.B9 (VBUS), U7.5 (VBUS)
VPWR: D2.2 (A), J2.A9 (VBUS), J2.B9 (VBUS)
VREF: C11.1, R7.2, R8.1, R14.2
XIN: C13.1, U1.20 (XIN), Y1.1
XOUT: R9.1, U1.21 (XOUT)
XTAL_OUT: C14.1, R9.2, Y1.3

Notes on the sheet:
USB and power
RP2040, flash, clock, debug
Instrument input
PCM1808 ADC and audio clock
PCM5102A DAC and line outputs
Headphone amplifier
Footswitches, LEDs, display
Expression jack
Mechanical

Board: 4 copper layers, 159 parts (0 on the bottom side), 111 nets, no tracks yet.
