webprofusion/open-pedal/(commit log)

2026-11-10 Initial design: docs, KiCad project, enclosure model and firmware skeleton
    RP2040 USB-C guitar audio dock with PCM1808 ADC and PCM5102A DAC, six
    LED-ring footswitches and an expression input. Includes the design
    document, script-generated KiCad 10 schematic and placed (unrouted)
    board, a Blender enclosure model with a removable device holder, and a
    USB MIDI foot controller firmware skeleton. Nothing has been built or
    measured yet.
    [bom.csv, open-pedal.kicad_pcb, open-pedal.kicad_sch]
2026-11-11 Path-traced renders with an iPad mini as the example tablet
    Render with Cycles using softbox and HDRI lighting, surface grain and
    render-time edge rounding. The example tablet is now an iPad mini showing
    a Soundshed Guitar screenshot. Add the tablet and front renders to the
    project README.
